nf-zvv/IVC_Tracer/(commit log)

2020-03-12 fix in UPDATE_ALL subroutine
    [IVC_Tracer.asm]
2020-03-14 added uart cmd interpreter
2020-03-14 command table moved to flash; bugfixes
    [cmd.asm, cmd_func.asm, uart_funcs.asm, uart_irq.asm, uart_macro.asm]
2020-03-14 added LOCATE_STR subroutine; bugfixes
    [IVC_Tracer.asm, cmd.asm, cmd_func.asm]
2020-03-16 some additions to uart terminal
2020-06-13 added voltage output format
